jsalazar423/actsat2026/Informes PDR y CDR/Cronograma del proyecto.png

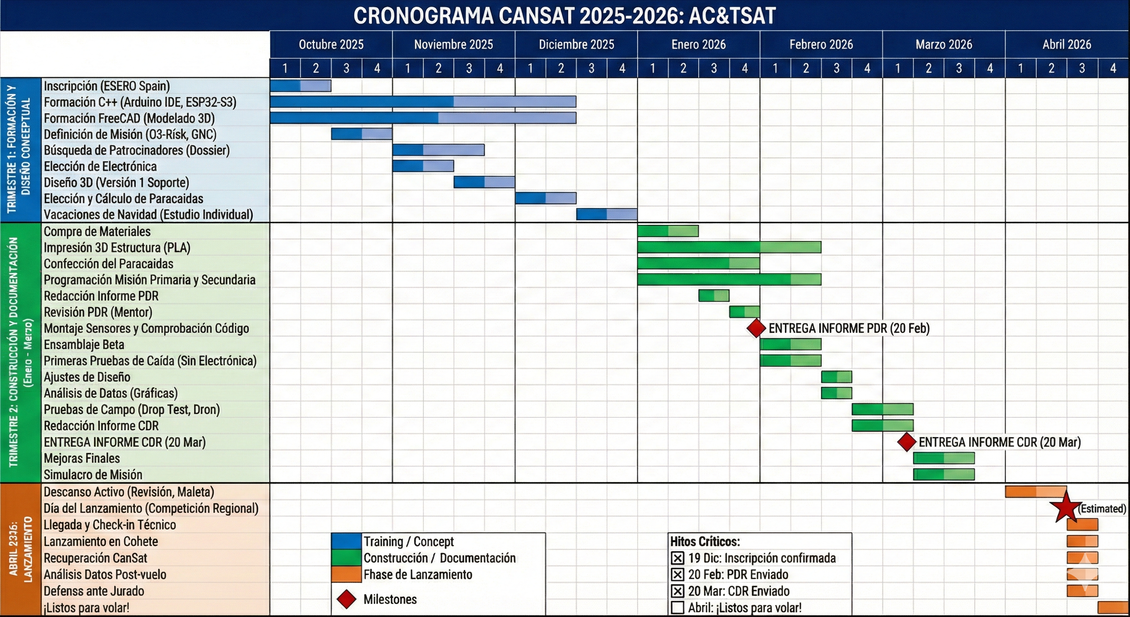
Informes PDR y CDR/Cronograma del proyecto.png
