jsalazar423/actsat2026/Informes PDR y CDR/Diagrama de conexiones.png

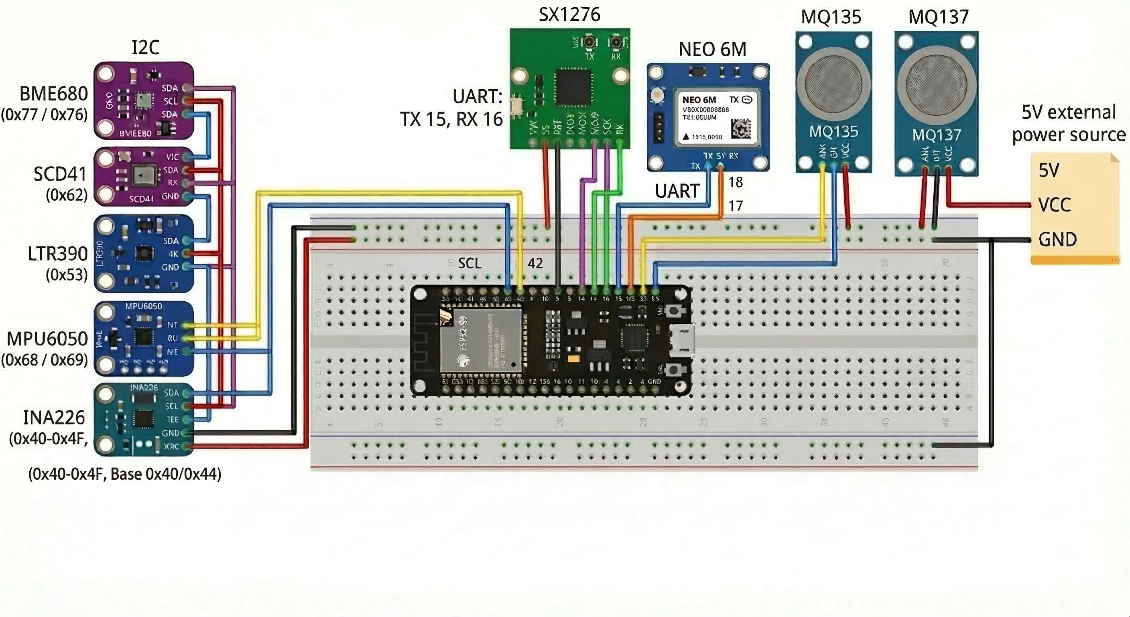
Informes PDR y CDR/Diagrama de conexiones.png
