jsalazar423/actsat2026/Informes PDR y CDR/Estación tierra.png

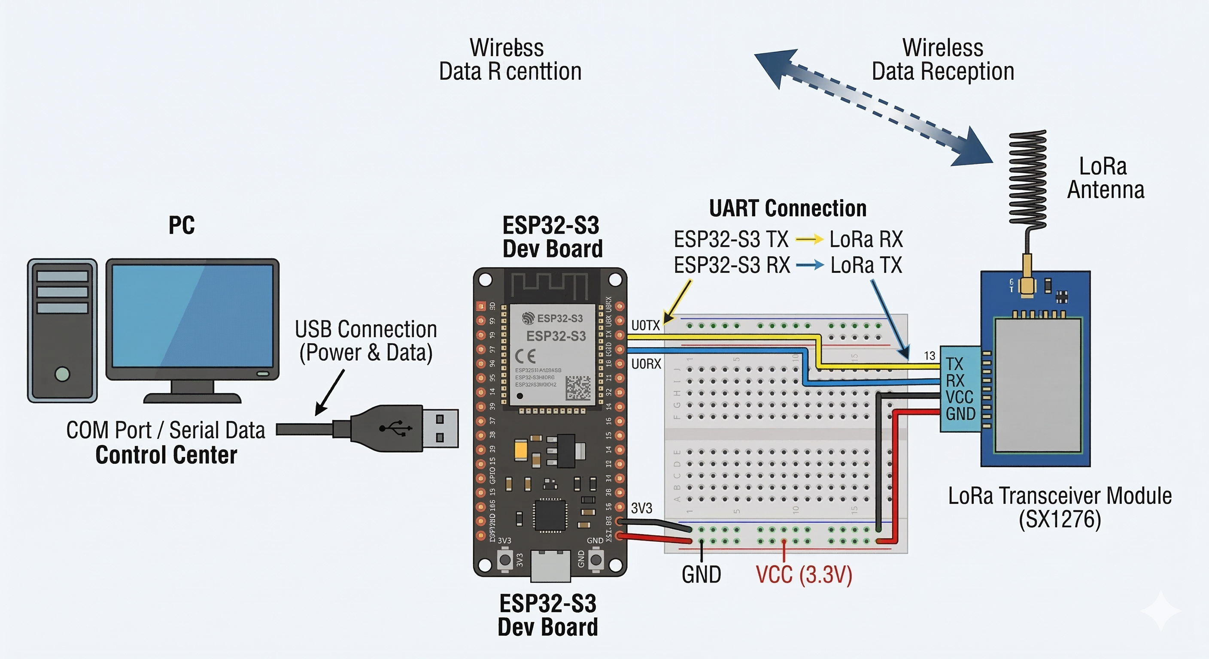
Informes PDR y CDR/Estación tierra.png
