jsalazar423/actsat2026/Estructura 3D/COVER FIRE EXTRA XXX (Meshed).stl

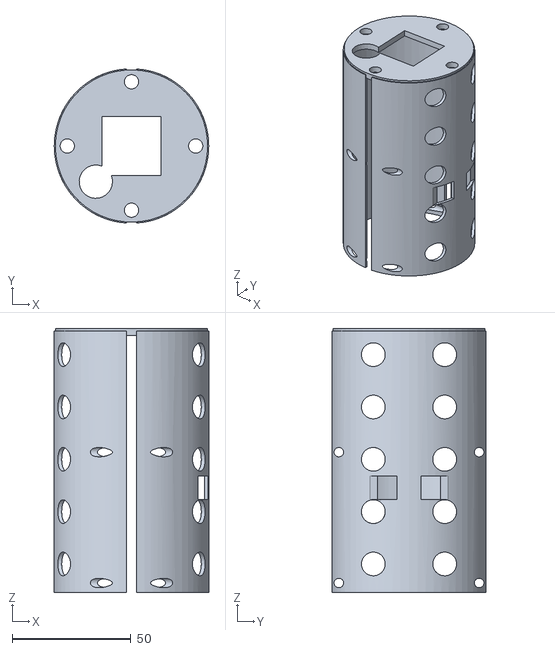
[picture p18: CAD file, 2026-05-21]
Estructura 3D/COVER FIRE EXTRA XXX (Meshed).stl
65.0 x 64.9 x 111.0
