jsalazar423/actsat2026/Estructura 3D/Cuerpo base final (Meshed).stl

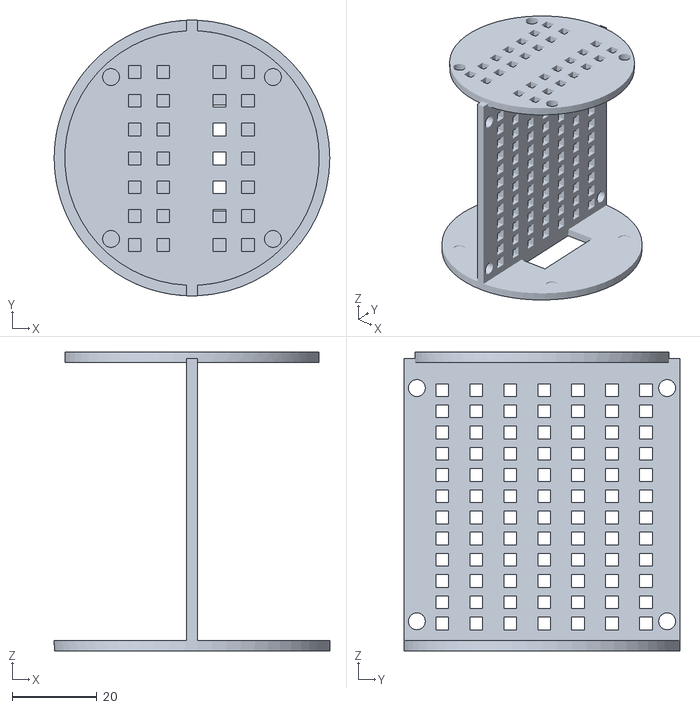
[picture p19: CAD file, 2026-05-21]
Estructura 3D/Cuerpo base final (Meshed).stl
65.0 x 65.0 x 70.5
